ericman2001/devin-epaper-display/hardware/epaper-display-schematic.pdf

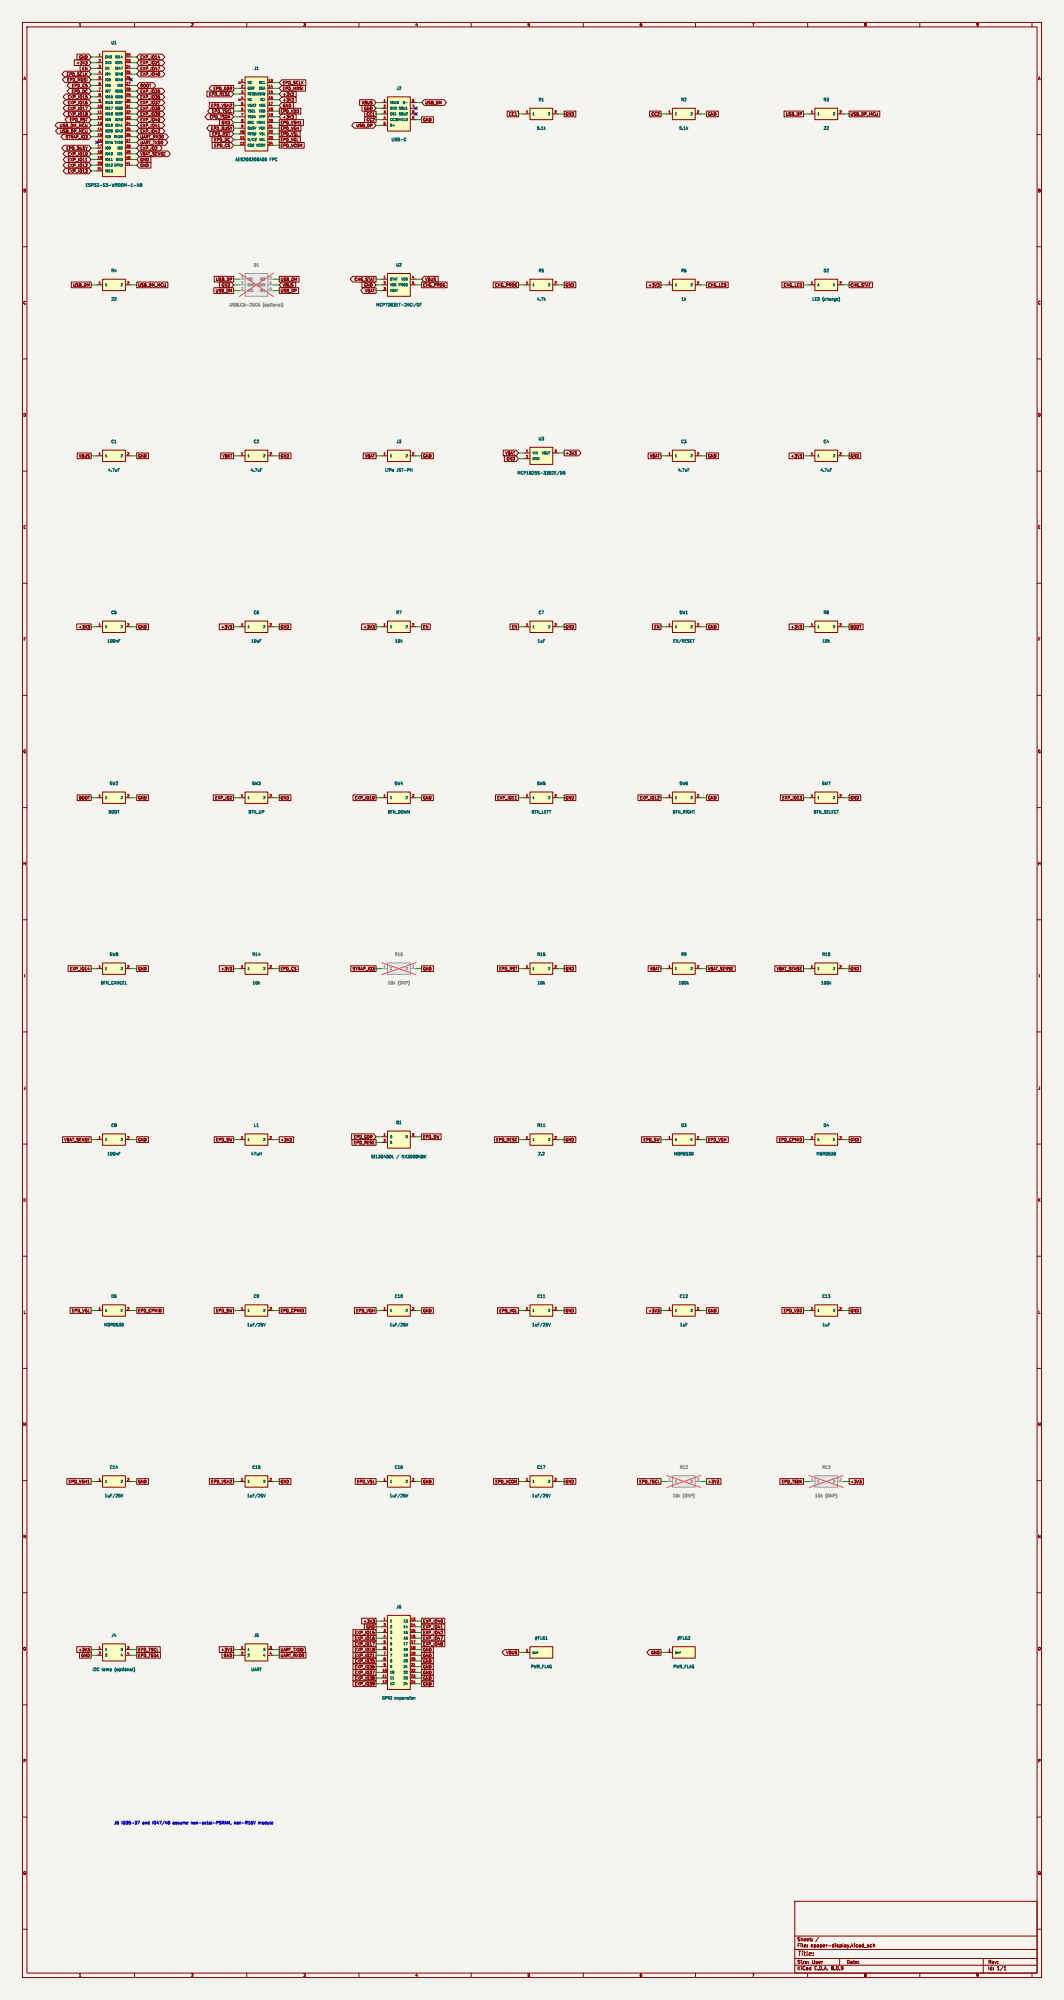
[picture p1: page 1]

Id: 1/1 Title: File: epaper-display.kicad_sch Sheet: /
