ericman2001/devin-epaper-display/hardware/epaper-display.kicad_sch

## KiCad design hardware/epaper-display.kicad_sch (2026-09-02)

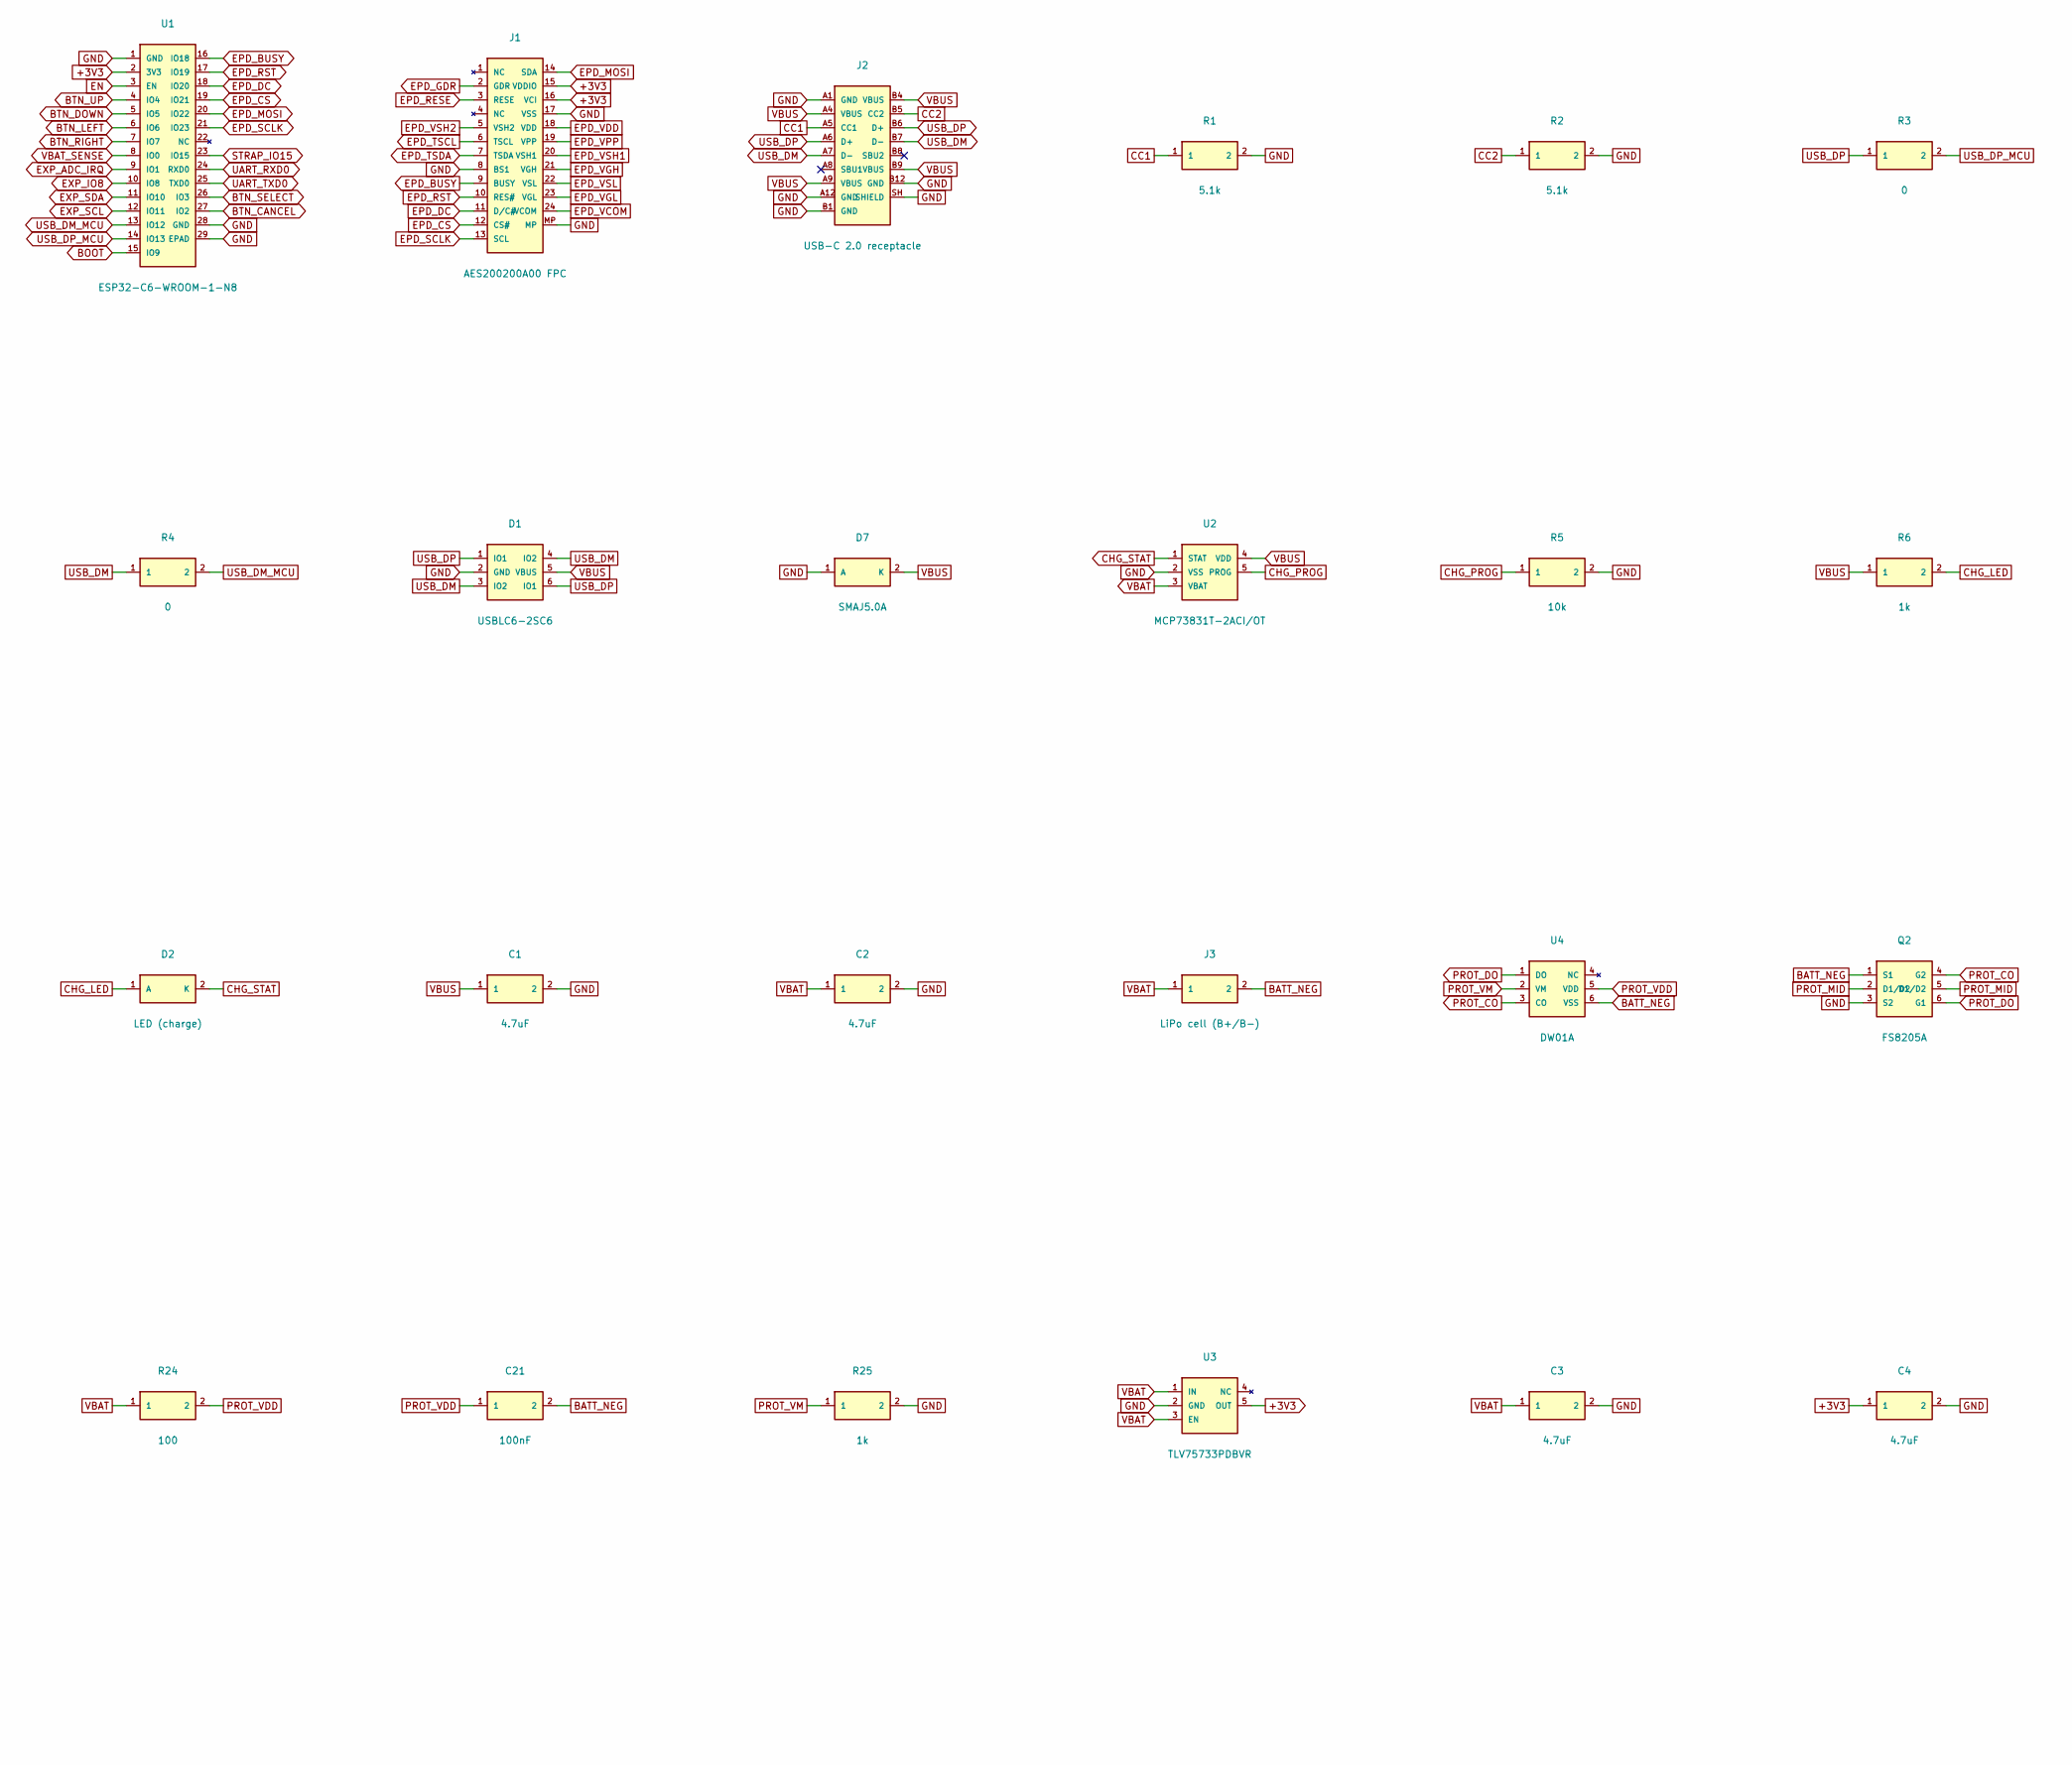
[picture p2: schematic epaper-display.kicad_sch, part in row 1, column 1]

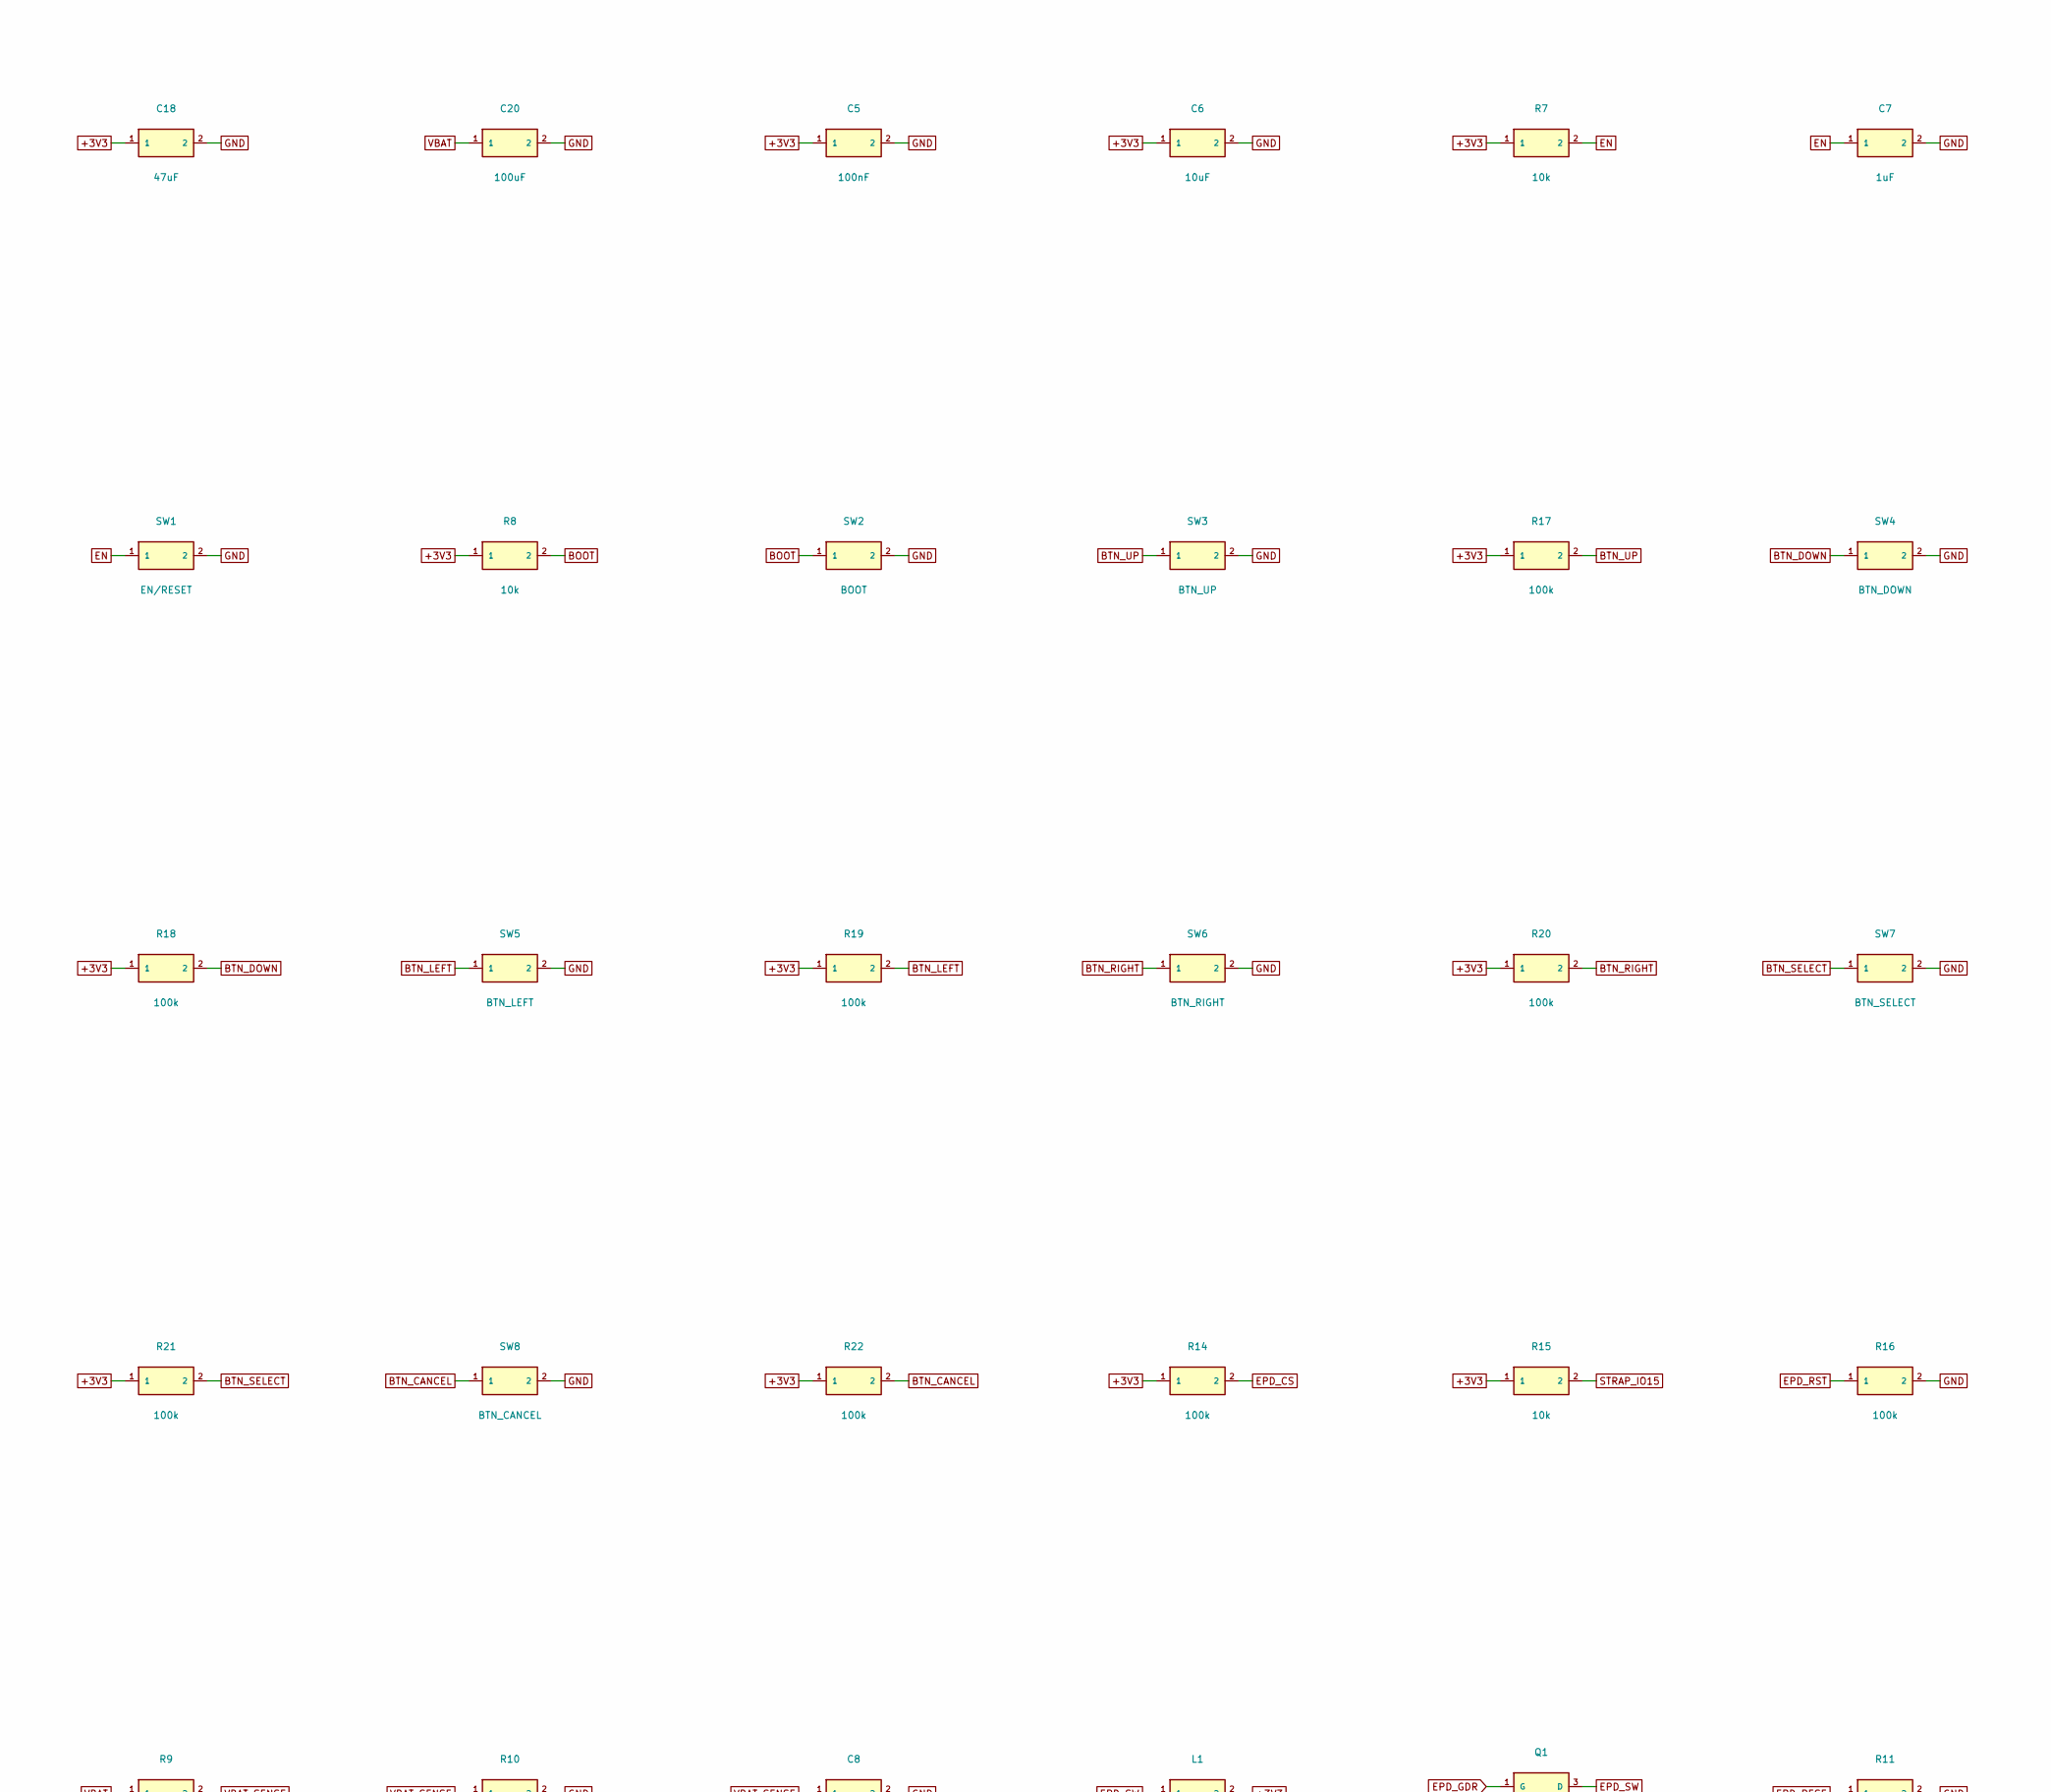
[picture p3: schematic epaper-display.kicad_sch, part in row 2, column 1]

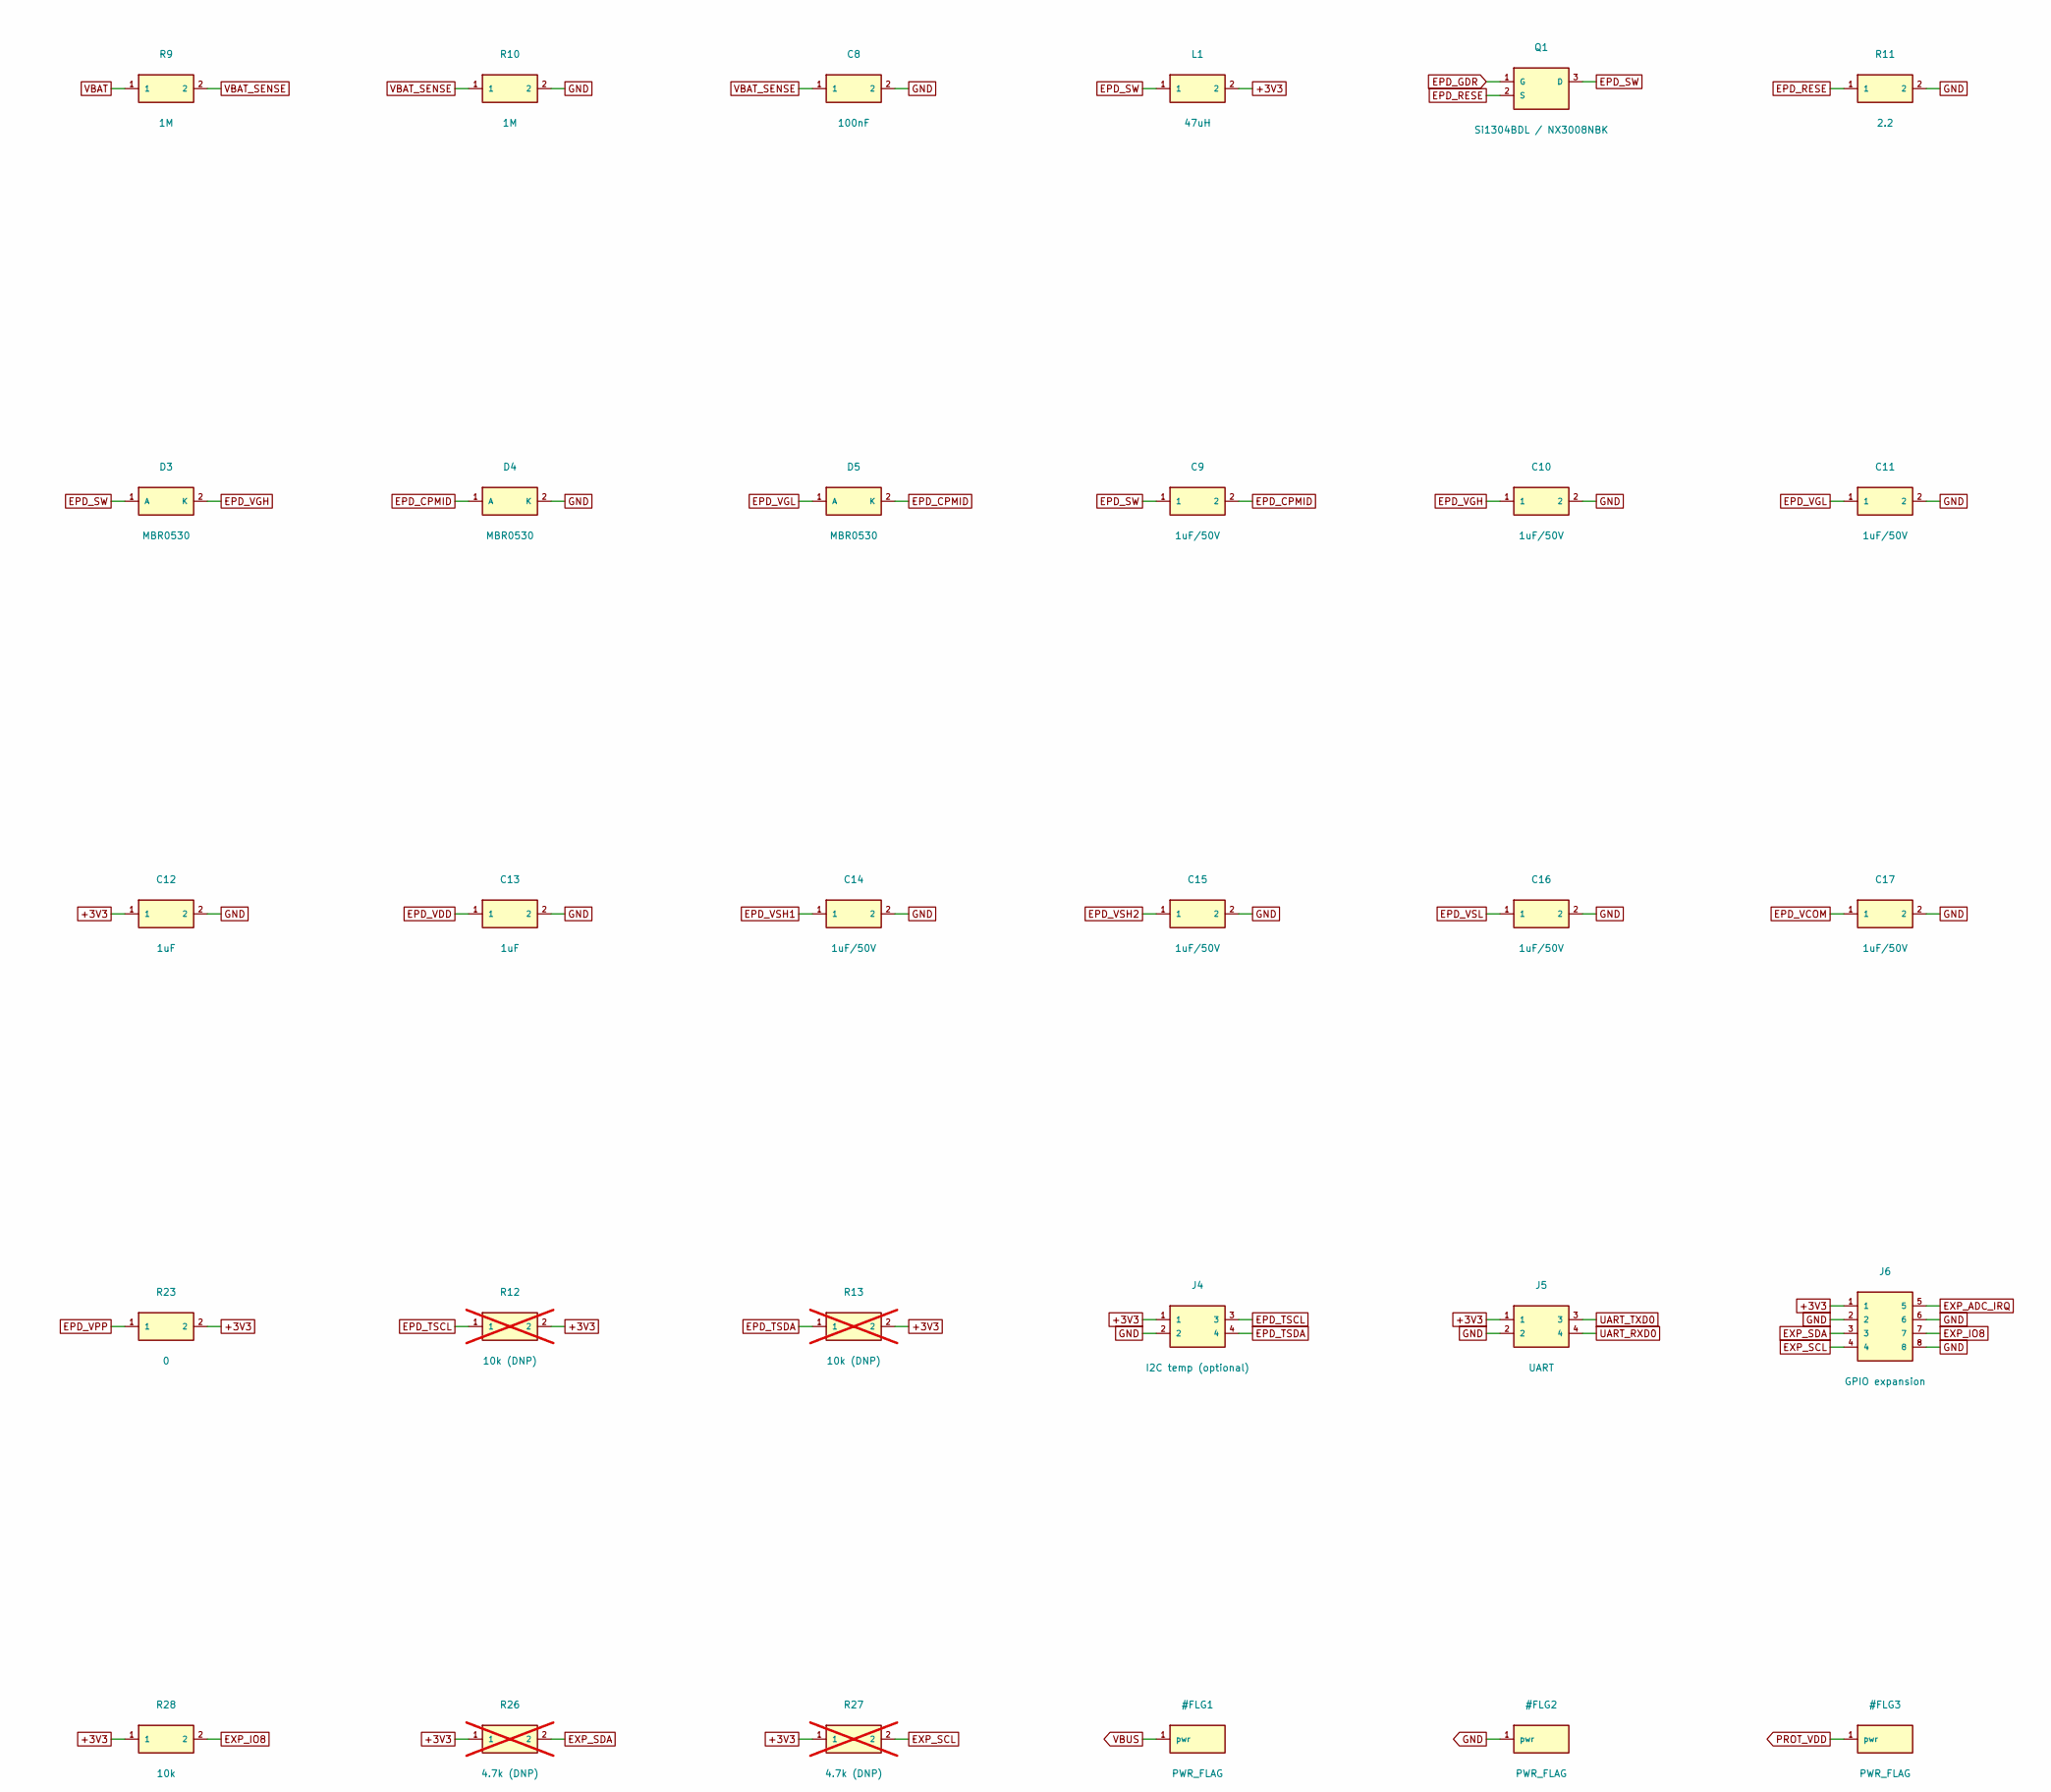
[picture p4: schematic epaper-display.kicad_sch, part in row 3, column 1]

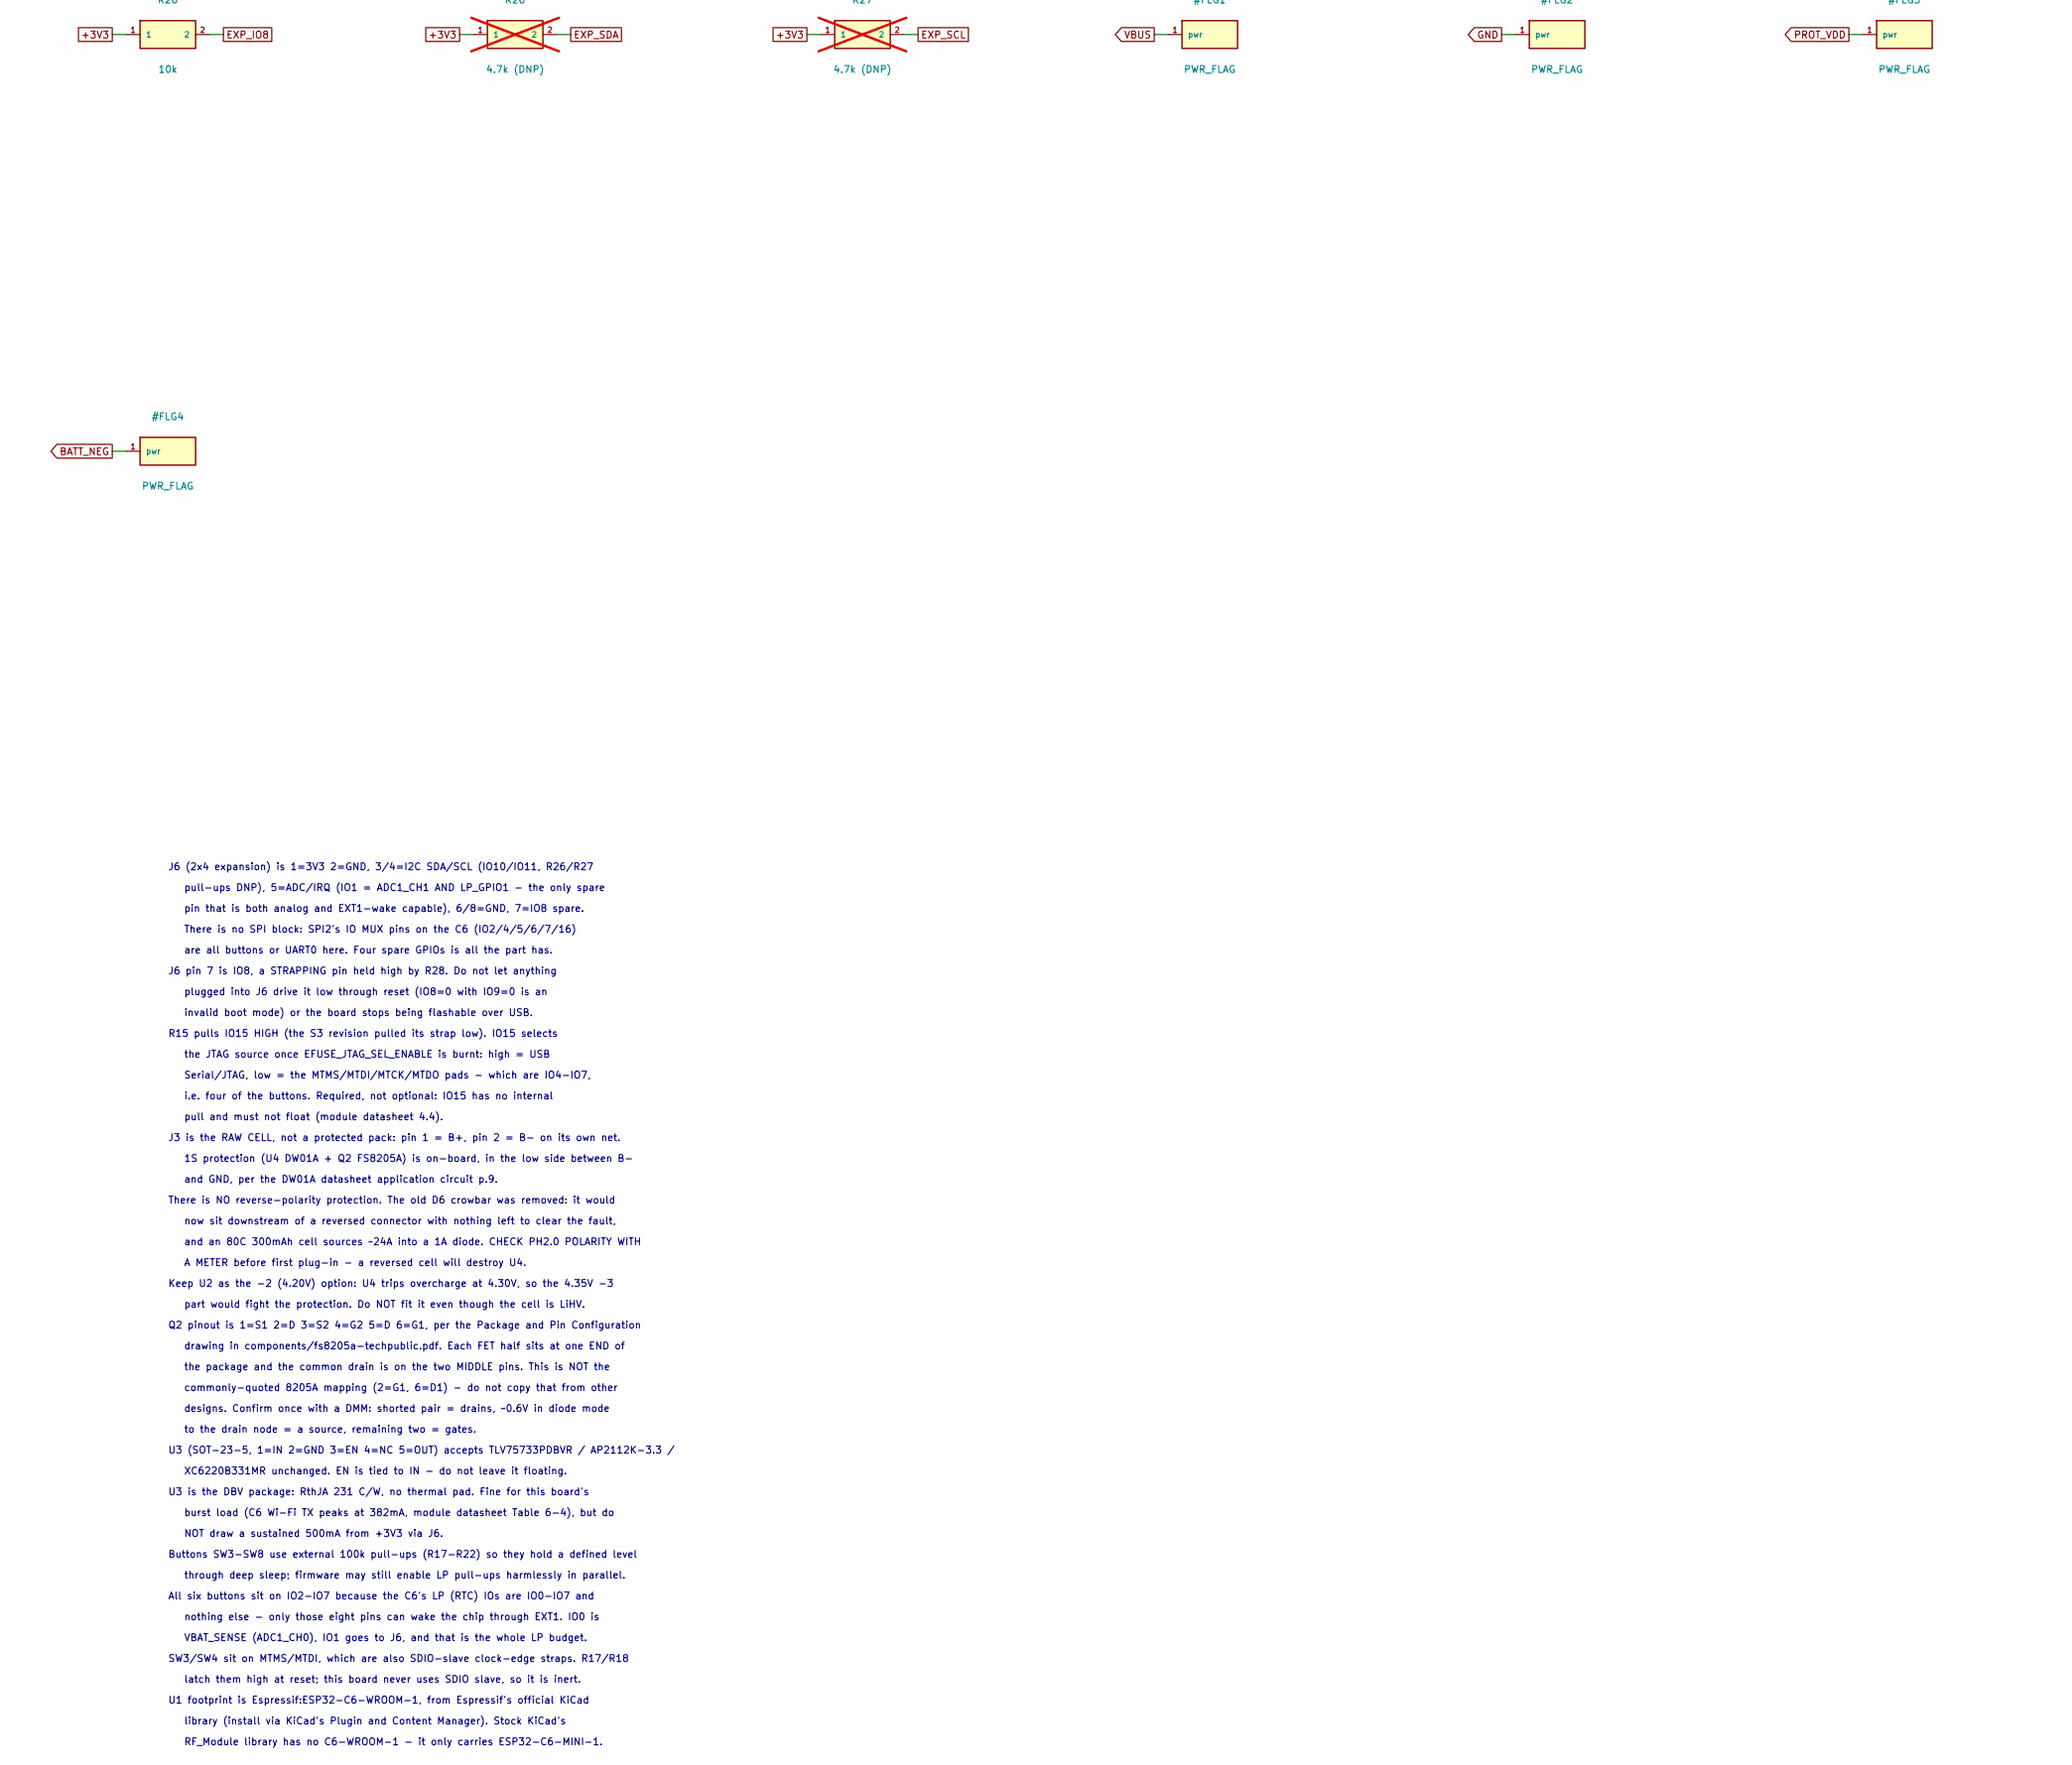
[picture p5: schematic epaper-display.kicad_sch, part in row 4, column 1]

Parts:
C1, C2, C3, C4: 4.7uF; C_0805_2012Metric
C5, C8, C21: 100nF; C_0805_2012Metric
C6: 10uF; C_0805_2012Metric
C7, C12, C13: 1uF; C_0805_2012Metric
C9, C10, C11, C14, C15, C16, C17: 1uF/50V; C_0805_2012Metric
C18: 47uF; C_1206_3216Metric
C20: 100uF; C_1206_3216Metric
D1: USBLC6-2SC6; SOT-23-6
D2: LED (charge); LED_D3.0mm
D3, D4, D5: MBR0530; D_SOD-123
D7: SMAJ5.0A; D_SMA
J1: AES200200A00 FPC; Hirose_FH12-24S-0.5SH_1x24-1MP_P0.50mm_Horizontal
J2: USB-C 2.0 receptacle; USB_C_Receptacle_GCT_USB4085
J3: LiPo cell (B+/B-); JST_PH_S2B-PH-K_1x02_P2.00mm_Horizontal
J4: I2C temp (optional); PinHeader_1x04_P2.54mm_Vertical
J5: UART; PinHeader_1x04_P2.54mm_Vertical
J6: GPIO expansion; PinHeader_2x04_P2.54mm_Vertical
L1: 47uH; L_Sunlord_MWSA0402S
Q1: Si1304BDL / NX3008NBK; SOT-23
Q2: FS8205A; SOT-23-6
R1, R2: 5.1k; R_0805_2012Metric
R3, R4, R23: 0; R_0805_2012Metric
R5, R7, R8, R15, R28: 10k; R_0805_2012Metric
R6, R25: 1k; R_0805_2012Metric
R9, R10: 1M; R_0805_2012Metric
R11: 2.2; R_0805_2012Metric
R12, R13: 10k (DNP); R_0805_2012Metric; not fitted
R14, R16, R17, R18, R19, R20, R21, R22: 100k; R_0805_2012Metric
R24: 100; R_0805_2012Metric
R26, R27: 4.7k (DNP); R_0805_2012Metric; not fitted
SW1: EN/RESET; SW_PUSH_6mm
SW2: BOOT; SW_PUSH_6mm
SW3: BTN_UP; SW_PUSH_6mm
SW4: BTN_DOWN; SW_PUSH_6mm
SW5: BTN_LEFT; SW_PUSH_6mm
SW6: BTN_RIGHT; SW_PUSH_6mm
SW7: BTN_SELECT; SW_PUSH_6mm
SW8: BTN_CANCEL; SW_PUSH_6mm
U1: ESP32-C6-WROOM-1-N8; ESP32-C6-WROOM-1
U2: MCP73831T-2ACI/OT; SOT-23-5
U3: TLV75733PDBVR; SOT-23-5
U4: DW01A; SOT-23-6

Connections:
+3V3: C4.1, C5.1, C6.1, C12.1, C18.1, J1.15 (VDDIO), J1.16 (VCI), J4.1, J5.1, J6.1, L1.2, R7.1, R8.1, R12.2, R13.2, R14.1, R15.1, R17.1, R18.1, R19.1, R20.1, R21.1, R22.1, R23.2, R26.1, R27.1, R28.1, U1.2 (3V3), U3.5 (OUT)
BATT_NEG: C21.2, J3.2, Q2.1 (S1), U4.6 (VSS)
BOOT: R8.2, SW2.1, U1.15 (IO9)
BTN_CANCEL: R22.2, SW8.1, U1.27 (IO2)
BTN_DOWN: R18.2, SW4.1, U1.5 (IO5)
BTN_LEFT: R19.2, SW5.1, U1.6 (IO6)
BTN_RIGHT: R20.2, SW6.1, U1.7 (IO7)
BTN_SELECT: R21.2, SW7.1, U1.26 (IO3)
BTN_UP: R17.2, SW3.1, U1.4 (IO4)
CC1: J2.A5 (CC1), R1.1
CC2: J2.B5 (CC2), R2.1
CHG_LED: D2.1 (A), R6.2
CHG_PROG: R5.1, U2.5 (PROG)
CHG_STAT: D2.2 (K), U2.1 (STAT)
EN: C7.1, R7.2, SW1.1, U1.3 (EN)
EPD_BUSY: J1.9 (BUSY), U1.16 (IO18)
EPD_CPMID: C9.2, D4.1 (A), D5.2 (K)
EPD_CS: J1.12 (CS#), R14.2, U1.19 (IO21)
EPD_DC: J1.11 (D/C#), U1.18 (IO20)
EPD_GDR: J1.2 (GDR), Q1.1 (G)
EPD_MOSI: J1.14 (SDA), U1.20 (IO22)
EPD_RESE: J1.3 (RESE), Q1.2 (S), R11.1
EPD_RST: J1.10 (RES#), R16.1, U1.17 (IO19)
EPD_SCLK: J1.13 (SCL), U1.21 (IO23)
EPD_SW: C9.1, D3.1 (A), L1.1, Q1.3 (D)
EPD_TSCL: J1.6 (TSCL), J4.3, R12.1
EPD_TSDA: J1.7 (TSDA), J4.4, R13.1
EPD_VCOM: C17.1, J1.24 (VCOM)
EPD_VDD: C13.1, J1.18 (VDD)
EPD_VGH: C10.1, D3.2 (K), J1.21 (VGH)
EPD_VGL: C11.1, D5.1 (A), J1.23 (VGL)
EPD_VPP: J1.19 (VPP), R23.1
EPD_VSH1: C14.1, J1.20 (VSH1)
EPD_VSH2: C15.1, J1.5 (VSH2)
EPD_VSL: C16.1, J1.22 (VSL)
EXP_ADC_IRQ: J6.5, U1.9 (IO1)
EXP_IO8: J6.7, R28.2, U1.10 (IO8)
EXP_SCL: J6.4, R27.2, U1.12 (IO11)
EXP_SDA: J6.3, R26.2, U1.11 (IO10)
GND: C1.2, C2.2, C3.2, C4.2, C5.2, C6.2, C7.2, C8.2, C10.2, C11.2, C12.2, C13.2, C14.2, C15.2, C16.2, C17.2, C18.2, C20.2, D1.2 (GND), D4.2 (K), D7.1 (A), J1.8 (BS1), J1.17 (VSS), J1.MP, J2.A1 (GND), J2.A12 (GND), J2.B1 (GND), J2.B12 (GND), J2.SH (SHIELD), J4.2, J5.2, J6.2, J6.6, J6.8, Q2.3 (S2), R1.2, R2.2, R5.2, R10.2, R11.2, R16.2, R25.2, SW1.2, SW2.2, SW3.2, SW4.2, SW5.2, SW6.2, SW7.2, SW8.2, U1.1 (GND), U1.28 (GND), U1.29 (EPAD), U2.2 (VSS), U3.2 (GND)
PROT_CO: Q2.4 (G2), U4.3 (CO)
PROT_DO: Q2.6 (G1), U4.1 (DO)
PROT_MID: Q2.2 (D1/D2), Q2.5 (D1/D2)
PROT_VDD: C21.1, R24.2, U4.5 (VDD)
PROT_VM: R25.1, U4.2 (VM)
STRAP_IO15: R15.2, U1.23 (IO15)
UART_RXD0: J5.4, U1.24 (RXD0)
UART_TXD0: J5.3, U1.25 (TXD0)
USB_DM: D1.3 (IO2), D1.4 (IO2), J2.A7 (D-), J2.B7 (D-), R4.1
USB_DM_MCU: R4.2, U1.13 (IO12)
USB_DP: D1.1 (IO1), D1.6 (IO1), J2.A6 (D+), J2.B6 (D+), R3.1
USB_DP_MCU: R3.2, U1.14 (IO13)
VBAT: C2.1, C3.1, C20.1, J3.1, R9.1, R24.1, U2.3 (VBAT), U3.1 (IN), U3.3 (EN)
VBAT_SENSE: C8.1, R9.2, R10.1, U1.8 (IO0)
VBUS: C1.1, D1.5 (VBUS), D7.2 (K), J2.A4 (VBUS), J2.A9 (VBUS), J2.B4 (VBUS), J2.B9 (VBUS), R6.1, U2.4 (VDD)

Notes on the sheet:
J6 (2x4 expansion) is 1=3V3 2=GND, 3/4=I2C SDA/SCL (IO10/IO11, R26/R27
pull-ups DNP), 5=ADC/IRQ (IO1 = ADC1_CH1 AND LP_GPIO1 - the only spare
pin that is both analog and EXT1-wake capable), 6/8=GND, 7=IO8 spare.
There is no SPI block: SPI2's IO MUX pins on the C6 (IO2/4/5/6/7/16)
are all buttons or UART0 here. Four spare GPIOs is all the part has.
J6 pin 7 is IO8, a STRAPPING pin held high by R28. Do not let anything
plugged into J6 drive it low through reset (IO8=0 with IO9=0 is an
invalid boot mode) or the board stops being flashable over USB.
R15 pulls IO15 HIGH (the S3 revision pulled its strap low). IO15 selects
the JTAG source once EFUSE_JTAG_SEL_ENABLE is burnt: high = USB
Serial/JTAG, low = the MTMS/MTDI/MTCK/MTDO pads - which are IO4-IO7,
i.e. four of the buttons. Required, not optional: IO15 has no internal
pull and must not float (module datasheet 4.4).
J3 is the RAW CELL, not a protected pack: pin 1 = B+, pin 2 = B- on its own net.
1S protection (U4 DW01A + Q2 FS8205A) is on-board, in the low side between B-
and GND, per the DW01A datasheet application circuit p.9.
There is NO reverse-polarity protection. The old D6 crowbar was removed: it would
now sit downstream of a reversed connector with nothing left to clear the fault,
and an 80C 300mAh cell sources ~24A into a 1A diode. CHECK PH2.0 POLARITY WITH
A METER before first plug-in - a reversed cell will destroy U4.
Keep U2 as the -2 (4.20V) option: U4 trips overcharge at 4.30V, so the 4.35V -3
part would fight the protection. Do NOT fit it even though the cell is LiHV.
Q2 pinout is 1=S1 2=D 3=S2 4=G2 5=D 6=G1, per the Package and Pin Configuration
drawing in components/fs8205a-techpublic.pdf. Each FET half sits at one END of
the package and the common drain is on the two MIDDLE pins. This is NOT the
commonly-quoted 8205A mapping (2=G1, 6=D1) - do not copy that from other
designs. Confirm once with a DMM: shorted pair = drains, ~0.6V in diode mode
to the drain node = a source, remaining two = gates.
U3 (SOT-23-5, 1=IN 2=GND 3=EN 4=NC 5=OUT) accepts TLV75733PDBVR / AP2112K-3.3 /
XC6220B331MR unchanged. EN is tied to IN - do not leave it floating.
U3 is the DBV package: RthJA 231 C/W, no thermal pad. Fine for this board's
burst load (C6 Wi-Fi TX peaks at 382mA, module datasheet Table 6-4), but do
NOT draw a sustained 500mA from +3V3 via J6.
Buttons SW3-SW8 use external 100k pull-ups (R17-R22) so they hold a defined level
through deep sleep; firmware may still enable LP pull-ups harmlessly in parallel.
All six buttons sit on IO2-IO7 because the C6's LP (RTC) IOs are IO0-IO7 and
nothing else - only those eight pins can wake the chip through EXT1. IO0 is
VBAT_SENSE (ADC1_CH0), IO1 goes to J6, and that is the whole LP budget.
SW3/SW4 sit on MTMS/MTDI, which are also SDIO-slave clock-edge straps. R17/R18
latch them high at reset; this board never uses SDIO slave, so it is inert.
U1 footprint is Espressif:ESP32-C6-WROOM-1, from Espressif's official KiCad
library (install via KiCad's Plugin and Content Manager). Stock KiCad's
RF_Module library has no C6-WROOM-1 - it only carries ESP32-C6-MINI-1.
