ericman2001/devin-epaper-display/(commit log)

2026-08-06 Added a charge manager
2026-08-06 updated microcontroller choices to support my soldering skills
2026-08-06 added LDO voltage regulator
2026-08-06 Add hand-solderable ESP32-S3 e-paper KiCad schematic under hardware/
    [epaper-display.kicad_sch]
2026-08-06 Fix charge-pump diode orientation, sheet overflow, USB symbol/footprint mismatch
    [epaper-display.kicad_sch]
2026-08-08 hardware: assign footprints to every BOM component, shape labels by pin type
    [epaper-display.kicad_sch]
2026-08-08 hardware: keep chip passives at 0805 for hand assembly
    [epaper-display.kicad_sch]
2026-08-08 hardware: justify left-side global labels away from symbols
    [epaper-display.kicad_sch]
2026-08-08 added component datasheet for the ESP32-S3
2026-08-08 hardware: apply ESP32-S3 pin review fixes
    [epaper-display.kicad_sch]
2026-08-08 hardware: hold e-paper panel in reset
    [epaper-display.kicad_sch]
2026-08-08 added switch selection
2026-08-08 Unify all buttons on FSJM 6x6mm THT footprint; add D-pad, select, cancel
    [epaper-display.kicad_sch]
2026-08-08 hardware: stabilize schematic note generation
    [epaper-display.kicad_sch]
2026-08-10 hardware: fix schematic issues found in datasheet review
    Reviewed the netlist against all six component datasheets. Fixes below;
    each one names the datasheet clause it comes from.
    Correctness:
    - R6 (charge LED) now returns to VBUS instead of +3V3. MCP73831 Fig 6-1
    puts RLED on VDD. Returning it to the regulated rail forward-biased the
    LED from the battery into the high-Z STAT pin whenever USB was absent,
    back-feeding the charger VDD node and the USB-C VBUS contact off the
    cell and breaking the "all I/O <= VDD + 0.3 V" absolute maximum.
    - R15 (GPIO3 strap) populated, was DNP. WROOM-1 datasheet 4.4: GPIO3 has
    no internal pull resistor and "must be controlled by the external
    circu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
    [epaper-display.kicad_sch]
2026-08-12 hardware: swap MCP1825S for TLV75733P (1A, 25uA Iq)
    The MCP1825S's 120 uA typ / 220 uA max quiescent current was ~15x the
    ESP32-S3's own deep-sleep draw and made the regulator the entire standby
    budget on a board that is asleep 99.98% of the time.
    Linear, not a switcher. Four reasons, in README 2:
    - At a 0.023% duty cycle the efficiency gap is worth ~0.1 mWh/day out of
    a ~5 mWh/day budget -- less than the regulator's own Iq contributes.
    - A plain buck cannot even do the job: a single LiPo spans 4.2-3.0 V,
    which straddles the 3.3 V output. Covering the full cell range needs a
    buck-boost, and those run 25-50 uA Iq, so there is no Iq win.
    - The genuinely low-Iq switchers (TPS62840, 60 n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
    [epaper-display.kicad_sch]
2026-08-12 hardware: document thermal design; copper, not heatsinks
    Worked the junction temperatures for every load case rather than
    assuming. Conclusion: no heatsink on U3, pour copper instead, and put
    the copper at U2 first.
    Why not a stick-on heatsink on U3:
    - The heat leaves through the leads, not the top. RthJC(top) is
    118.4 C/W (5.4) -- junction to the top of the plastic alone. A
    top-mounted sink is in series behind that, so even a perfect one
    holding the case at ambient cannot get RthJA below ~118 C/W.
    - Copper alone beats that for free. TI quotes the same DBV package at
    231.1 C/W on the JEDEC board (note the qualifier: "no vias to internal
    plane and bottom layer") and 100.8 C/W on t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
    [epaper-display.kicad_sch]
2026-08-12 hardware: document the 300 mAh cell and its peak-current constraint
    The target cell is a 300 mAh 3.7 V LiPo, so the figures documented
    against a 500 mAh cell are restated, and one new constraint appears.
    Energy: ~1000 mWh usable to a 3.5 V floor gives ~5 months at 4
    updates/day. Standby is a flat ~3.8 mWh/day floor, so past ~4 updates a
    day the Wi-Fi wake cycles are the whole budget -- hourly updates cut life
    to ~2 months. Cadence is the lever, not capacity.
    Internal resistance is the constraint the smaller cell adds. A 300 mAh
    pouch runs 200-400 mOhm including its PCM against maybe 150 mOhm for a
    500 mAh cell, and that sag stacks on the LDO dropout:
    Ri=300mOhm, TX only 355mA s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
    [epaper-display.kicad_sch]
2026-08-12 hardware: target the Turnigy BoltX LiHV pack + inline 1S protection
    The chosen cell is a Turnigy BoltX LiHV 1S 300mAh 3.8V 80C whoop pack.
    No schematic change follows from it, but three things needed saying and
    one of them is a safety matter.
    The pack is an unprotected drone cell. Whoop packs ship as bare cells --
    maximum discharge rate, minimum weight, low-voltage cutoff delegated to
    the flight controller. That is incompatible with this board in two ways:
    nothing here stops over-discharge, and D6 shorts a reversed cell *on
    purpose*, relying on the pack's protection to clear the fault. An 80C
    300mAh cell is rated for 24 A; an SS14 across that with nothing to
    interrupt it is worse than havin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
    [epaper-display.kicad_sch]
2026-08-12 hardware: make gen_sch.py import-safe; ignore __pycache__
    Importing gen_sch.py to inspect the netlist -- for BOM cross-checks or
    connectivity audits -- executed the module body, which rewrote
    epaper-display.kicad_sch, epaper.kicad_sym, sym-lib-table and the .pro
    root UUID as a side effect. Every such inspection left the working tree
    dirty with a large diff that was pure UUID churn, which is both noise
    and a good way to hide a real change.
    The definitions and the netlist self-checks stay at module level, so
    `import gen_sch` still validates and still exposes `instances` and
    `symdefs`. Only the file writing moves behind `if __name__ ==
    "__main__"`.
    Behaviour is unchanged: the diff adds exactl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
    [epaper-display.kicad_sch]
2026-08-12 hardware: add on-board 1S protection (DW01A + FS8205A); remove D6
    Moves the 1S protection from an inline module onto the board, so J3 is
    now the raw cell rather than a protected pack. Wired exactly as the
    DW01A datasheet application circuit (p.9) draws it:
    J3.1 = B+ = VBAT (high side never switched)
    J3.2 = B- on its own net (BATT_NEG), NOT board GND
    R24 100R VBAT -> U4 VDD ; C21 100nF VDD-VSS ; U4 VSS -> B-
    Q2 half 1 = discharge control (G1 <- DO, S1 = B-)
    Q2 half 2 = charge control (G2 <- CO, S2 = GND/P-)
    Q2 D1/D2 commoned ; U4 VM -> R25 1k -> GND
    The gate/source pairing is set by the DW01A, which turns the discharge
    FET off by driving DO to VSS and the charge FET off by d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
    [epaper-display.kicad_sch]
2026-08-12 hardware: FS8205A pinout is unresolved, not confirmed — flag it hard
    The Tech Public FS8205A datasheet does not confirm the pin numbering.
    It contradicts it, which makes the open item sharper rather than
    closing it.
    What it adds: a "Package and Pin Configuration" isometric that labels
    functions by position -- one row S1 / D1/D2 / S2, the other row G1 /
    D1/D2 / G2. Sources at the ends of one row, gates at the ends of the
    other, a drain in the MIDDLE of each row.
    That arrangement is incompatible with the commonly-quoted 8205A mapping
    currently wired (1=S1 2=G1 3=S2 4=G2 5=D2 6=D1), which puts a gate in
    the middle of the source row and both drains adjacent on the other. The
    two candidates a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
    [epaper-display.kicad_sch]
2026-08-12 hardware: correct Q2 FS8205A pinout to the Tech Public drawing
    The FS8205A pinout is resolved, and the mapping previously wired was
    wrong. Corrected to what the "Package and Pin Configuration" drawing in
    components/fs8205a-techpublic.pdf shows:
    pin 6 G1 pin 5 D1/D2 pin 4 G2
    pin 1 S1 pin 2 D1/D2 pin 3 S2
    Each FET half occupies one END of the package (FET1 = S1/G1 on pins 1/6,
    FET2 = S2/G2 on pins 3/4) with the common drain on the two MIDDLE pins.
    A symmetric leadframe, which is corroborating in itself.
    This is NOT the commonly-quoted 8205A mapping (1=S1 2=G1 3=S2 4=G2 5=D2
    6=D1) that the previous revision used, and the difference mattered: pins
    2 and 6 wer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
    [epaper-display.kicad_sch]
2026-08-21 hardware: ignore KiCad per-user state and editor local history
    *.kicad_prl and the lock/backup files are per-user UI state, not design
    data, and .history/ is the VS Code Local History extension's scratch dir.
2026-08-21 hardware: fix J2 shield pad name, connect J1 hold-downs, make UUIDs stable
    Four fixes, all surfaced while bringing up the PCB from this schematic.
    J2 shield pin was numbered S1, but every USB-C footprint in KiCad's
    Connector_USB library names its shield pads SH -- S1 is what KiCad's own
    USB-C *symbol* uses. "Update PCB from Schematic" failed outright with
    "pad S1 not found in Connector_USB:USB_C_Receptacle_GCT_USB4085".
    J1's Hirose FH12 footprint has two mechanical hold-down tabs (both pads
    named MP) with no matching symbol pin, so they were left floating -- a
    silent mismatch, since KiCad does not flag unmatched footprint pads.
    Added an MP pin tied to GND; those tabs are what hold the con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
    [epaper-display.kicad_sch]
2026-08-27 hardware: reorganise J6 into a blocked SPI/I2C/ADC expansion header
    J6 was a 2x12 that broke 15 spare GPIOs out in numeric order and padded
    the last six positions with GND. Same 15 GPIOs now sit on a 2x10 laid out
    in functional blocks, so a peripheral wires to one contiguous corner:
    1-8 3V3, GND, SPI SCLK/MOSI/MISO/CS (IO38-41), IRQ (IO11), GND
    9-10 I2C SDA/SCL (IO12/IO13), R26/R27 4.7k pull-ups fitted DNP
    11,13 ADC1 inputs (IO2, IO10), each facing a GND pin
    15-20 six spare GPIOs, with the PSRAM-variant-sensitive ones last
    Two choices drove the pin picks:
    * The IRQ line is an RTC GPIO. Only GPIO0-21 can wake the chip from deep
    sleep through EXT1, so an interrupt on GPIO35-48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
    [epaper-display.kicad_sch]
2026-09-02 updated main processor to ESP32-C6-WROOM-1-N8; documentation update
2026-09-02 hardware: switch the main processor to ESP32-C6-WROOM-1-N8 (RISC-V)
    Replaces the ESP32-S3-WROOM-1-N8 (dual-core Xtensa) with the
    ESP32-C6-WROOM-1-N8 (single-core RISC-V, Wi-Fi 6 / BLE 5.3 / 802.15.4).
    Same 18.0 x 25.5 x 3.1 mm module outline, but 29 pads against 41 in a
    different order, so this is a full symbol, footprint and pin-map change --
    not a drop-in. All pin data is taken from Table 3-1 and chapter 4 of
    components/esp32-c6-wroom-1_wroom-1u_datasheet_en.pdf (v1.4).
    The C6 breaks out 23 usable GPIOs where the S3 gave 36, and three scarce
    resources share the same GPIO0-GPIO7 block: LP (RTC) IOs, which are the
    only pins EXT1 can wake from; ADC1, the chip's only ADC; and the SPI2 IO
    MUX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
    [epaper-display.kicad_sch]
2026-09-02 hardware: document that the panel keeps a real hardware SPI bus
    The previous commit's wording ("panel SPI therefore runs through the GPIO
    matrix ... that costs nothing") was looser than it should have been and
    invites the reading that the buttons took the SPI port. They did not:
    they took the SPI2 *IO MUX pins*, not the SPI *controller*. The panel is
    driven by GPSPI2 (SPI2_HOST) in hardware with DMA, exactly as on the S3
    revision; only the dedicated IO MUX pads are unavailable.
    Replaces the hand-waving with the two figures that actually settle it:
    * the panel's own ceiling is 20 MHz write / 2.5 MHz read (panel
    datasheet Table 7-4), and
    * ESP-IDF's spi_master docs state that for thi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
    [gen_sch.py]
